AshishCdev/Nelson-pass-Class-A-amplifier/Docs/art_amp_camp_1.pdf

## AMP CAMP AMP #1

by Nelson Pass

Introduction

Do-It-Yourself audio is a great activity. Many major audio components are easily constructed and made to perform as well or better than what we see in the stores and at considerable savings. The process is educational and therapeutic and there are few greater satisfactions than listening to music on equipment you have built yourself.

One of the problems that people face getting involved in DIY audio is the initial hurdle of just getting started. Toward this end, it is a big help if the project is simple and structured and there is some “hand holding” available.

A good example of this is when several years ago Nelson Brock and his family sponsored “Speaker Camp”, an activity in which a number of people paid a modest sum to show up on a Saturday morning and spend the day building their own loudspeakers. At the end of the day they each carted away a respectable stereo pair.

This year in loose association with Burning Amp and DIYAudio, they are holding “Amp Camp”, with the aim of introducing a group of people to DIY amplifier construction. When approached, I offered some design work and parts to assist this effort.

On June 30, about 25 people will show up on the Brock's property, and with a little luck at the end of the day they will cart away 50 small mono-block Class A power amplifiers.

Requirements and Constraints

Building amplifiers is generally a more intimidating challenge than loudspeakers. There are more parts involved, the function of these parts seems more exotic, and they are connected in more complex ways.

In thinking about the design, I considered whether a “chip amp” might be suitable. This would be an amplifier based around a commercially available integrated circuit in which most of the complexity is hidden inside a single component. This approach looks easier, but is a little less “fundamental” than a design using discrete transistors to form the circuit. If you think of this project positioned on a range of DIY complexity, at one extreme you take a pail of sand and start fabricating your own transistors from scratch. At the other end of the scale you go to the store and buy a Bose system. This project leans toward the former.

Besides, who says that discrete designs have to be complicated? It is possible to build a nice amplifier with only a few more connections than a chip amp, and for a little more effort you can learn even more and get more enjoyment out of the finished product.

So Amp Camp Amp #1 is a discrete design using four transistors. It can be built for about the same cost as a chip amp and in the same amount of time. It will not measure as well as chip

amps in some regards, but as a single-ended Class A design with minimal feedback it will sound good and get some high end audiophile respect.

We have to seriously consider safety as a constraint with regard to the power supply circuitry for the amplifier. We assume that most of the participants in this project do not have the skills to safely connect the components which make up an amplifier power supply to the AC power line.

I addressed this by choosing a commercially available switching supply of the type you routinely see powering up your portable computer. There are literally tons of surplus supplies available for this purpose, providing regulated 19 volts DC at more than 2 amps or so on their output and having their input going safely to the wall AC power outlet through a safety approved power cord. These supplies are isolated for shock safety and are also short-protected. At 19 volts output they do not represent much of a hazard to humans.

What? An audiophile component with a switching power supply? Get over it – it works fine.

The Design

As mentioned before, we want a simple, good sounding design. For the past twenty years or so I've been writing up single stage “Zen” amplifiers and other simple designs, and we are going to channel some of those to get what we want. Here is the very simplified circuit:

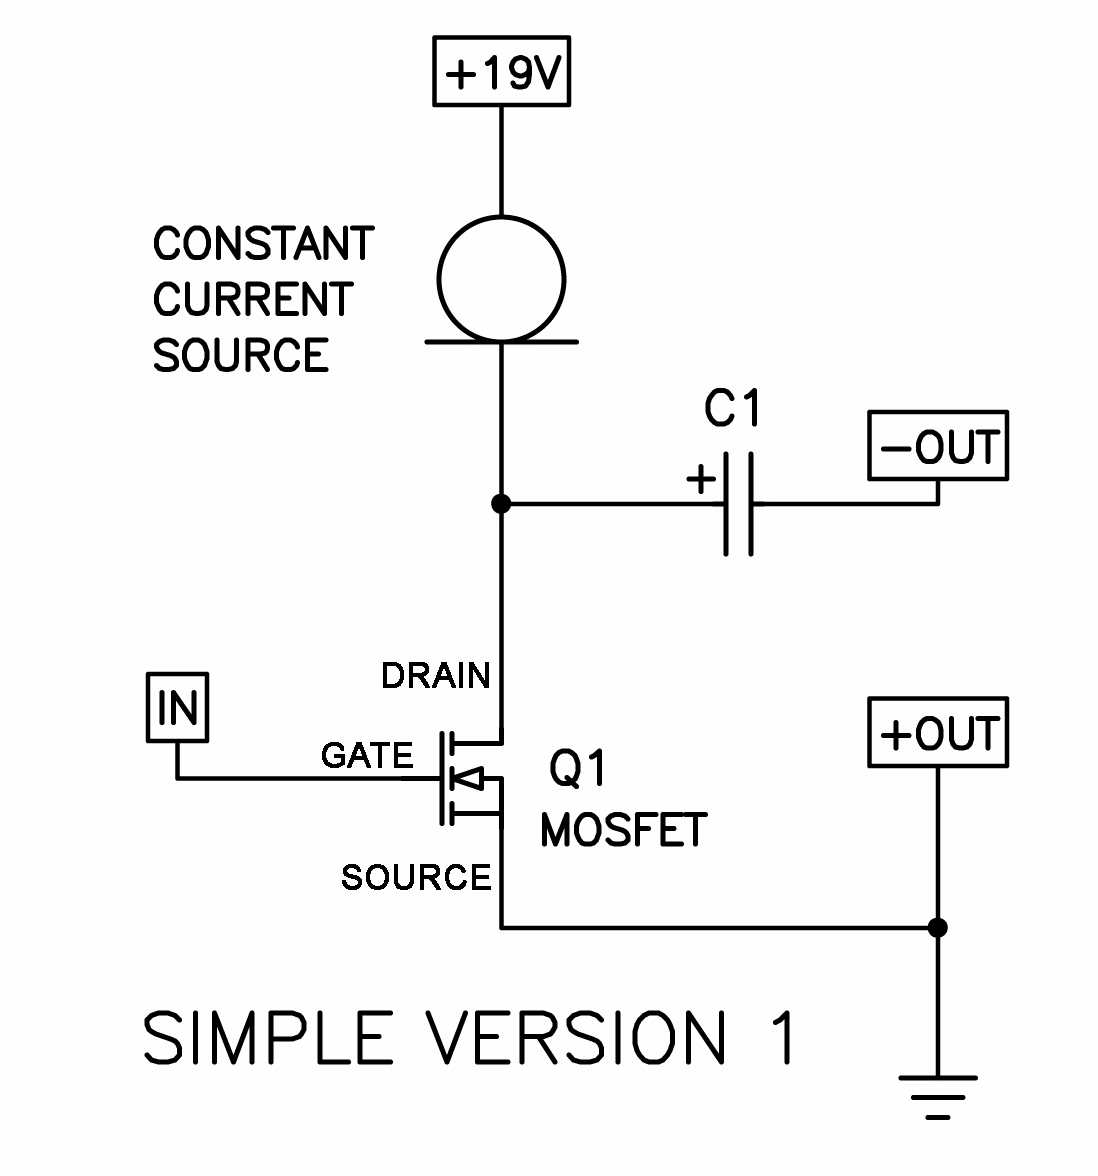
[picture p1: figure]

In this circuit we see a single gain element Q1, an N-channel power Mosfet. In the diagram you will see that the three pins on this device are labeled Source, Drain and Gate. The input signal comes to the Mosfet Gate pin, and the output signals appears at the Drain pin. The Source is attached to circuit Ground. This arrangement is known as “Common-Source” operation. Of the three possible ways of operating a Fet gain device, it is the one that offers both voltage and current gain.

The other two operating modes are known as Common-Drain and Common-Gate. Common-Drain has the signal input going to the Gate pin and takes the output from the Source pin. It offers current gain, but not voltage gain. Common-Gate operation has input to the Source pin and takes the output from the Drain. It offers voltage gain but not current gain.

This Common-Source Mosfet is operated single-ended Class A. This means that power goes into the circuit from one end only, and the transistor will be conducting current at all times through its operation. This current is delivered to the transistor through the Constant Current Source, which is a circuit which provided constant current, (ideally) no matter what the voltage conditions are. This constant current is shared by the Mosfet and the loudspeaker, and the input signal varies the degree to which these elements share this current, and this is what drives the loudspeaker.

We will note that Common-Source operation intrinsically inverts the phase of the amplified signal, and so we have reversed the polarity of the output terminals to account for that.

As a concept, you can buy an integrated circuit constant current source, but we are going to design our own, partly to do-it-ourselves and partly because we want to alter its character a little to improve the performance of the circuit. Here is the circuit with some details added showing the actual discrete circuit of our current source:

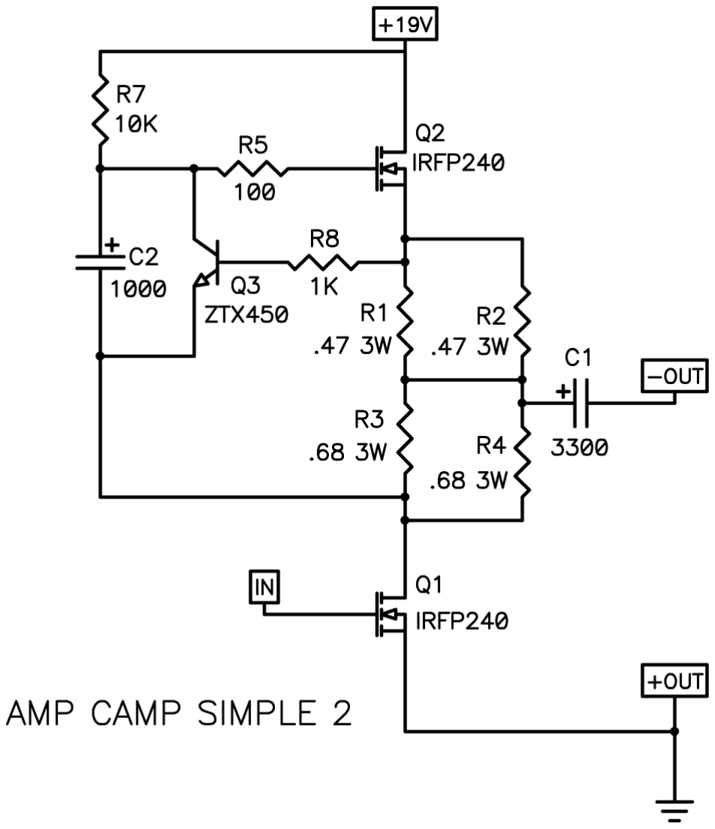
[picture p2: figure]

First we note that Q1 now actually has a part description IRFP240 which is a nice venerable power Mosfet which has been around for over 20 years. There is also Q2 which is the same type of Mosfet. Surrounding Q2 are several resistors, a small transistor Q3, and a capacitor. These elements are chosen to control Q2 in such a way that it acts as a DC constant current source which also varies AC-wise so as to favorably help the amplification provided by Q1.

Q3 is used to set up the DC operation of Q2 by adjusting a constant DC voltage across C2. This sets the current source at a constant DC value by sensing the voltage drop from the Source of Q2 to the Drain of Q1 and keeping the it at the same value as the Base-Emitter voltage required to make Q3 conduct - about 0.65 Volts.

The AC current of this circuit is made variable by tapping the output to the speaker from the midpoint of the power resistors R1 through R4. This sort of arrangement has several names, including SRPP and SEPP, but my favorite is “mu follower”.

The above circuit does not yet make allowance for providing the correct DC voltage on the Gate pin of Q1 so as to conduct electricity. Also, there is not yet a provision for any negative feedback so as to create a low enough output impedance and low enough distortion to make the performance of the amplifier generally attractive.

The circuit below shows additions Q4, P1, C3, and R10 to accomplish these things. C3 allows us to set a DC voltage on the Gate of Q1 (about 4 volts) and we get this through P1 and R10. Q4, a Jfet transistor operated in Common-Drain mode provides a buffer that keeps the input impedance high. This will be helpful in driving the Q1 Gate capacitance when it comes time to enclose this circuit in a feedback loop while keeping the input impedance high enough that it doesn't have problems with the preamp circuits which might be driving this amplifier.

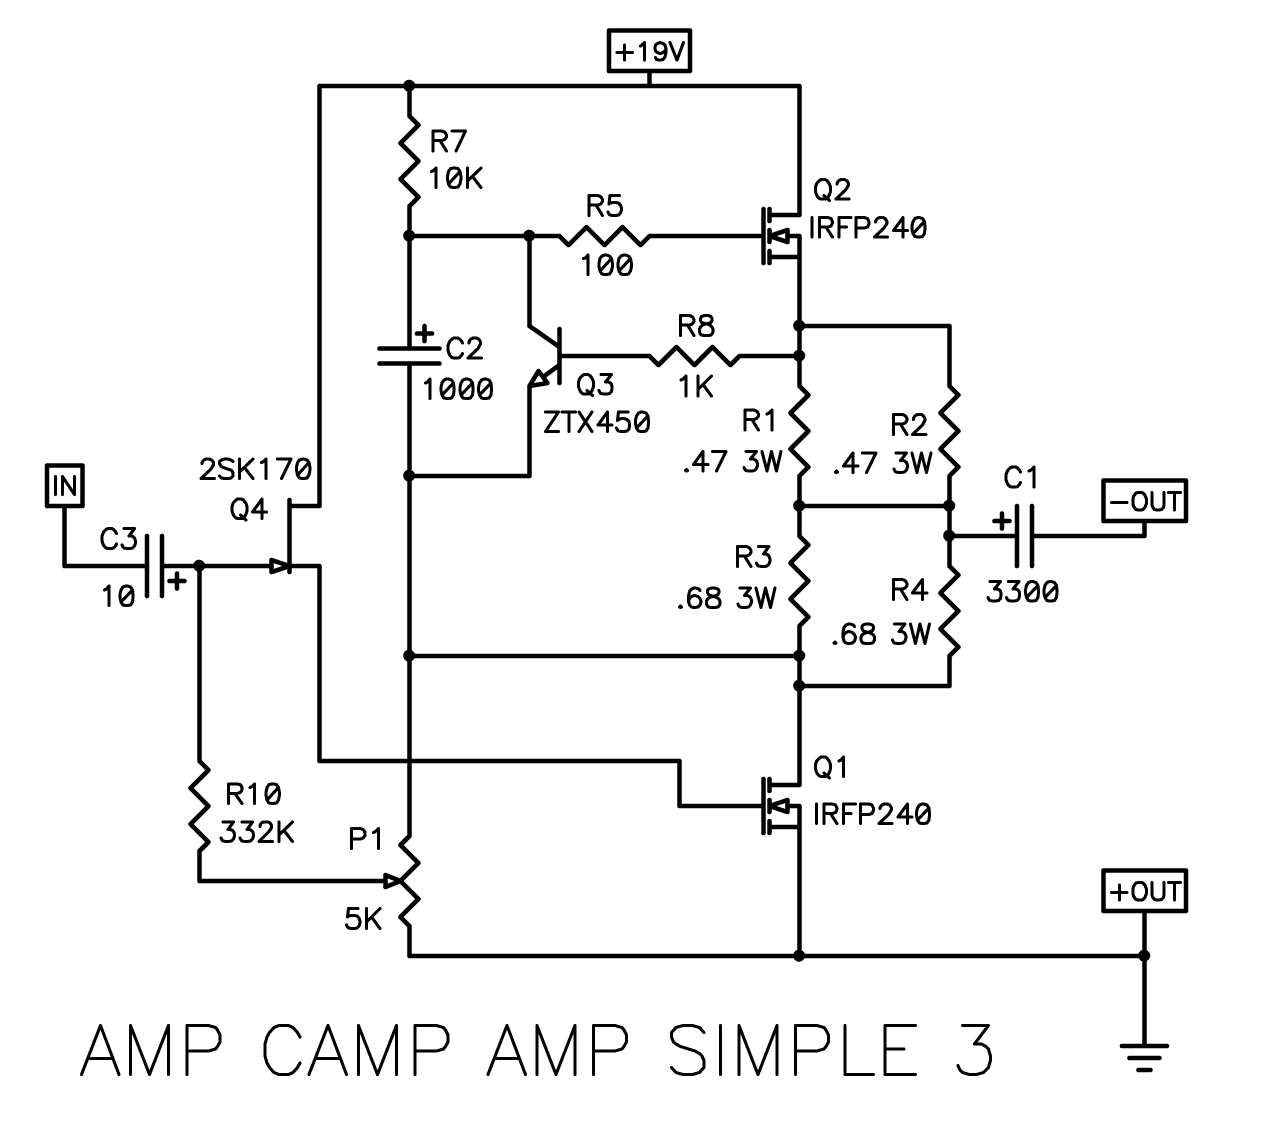
[picture p3: figure]

There are a few more details to be added before we have the final circuit:

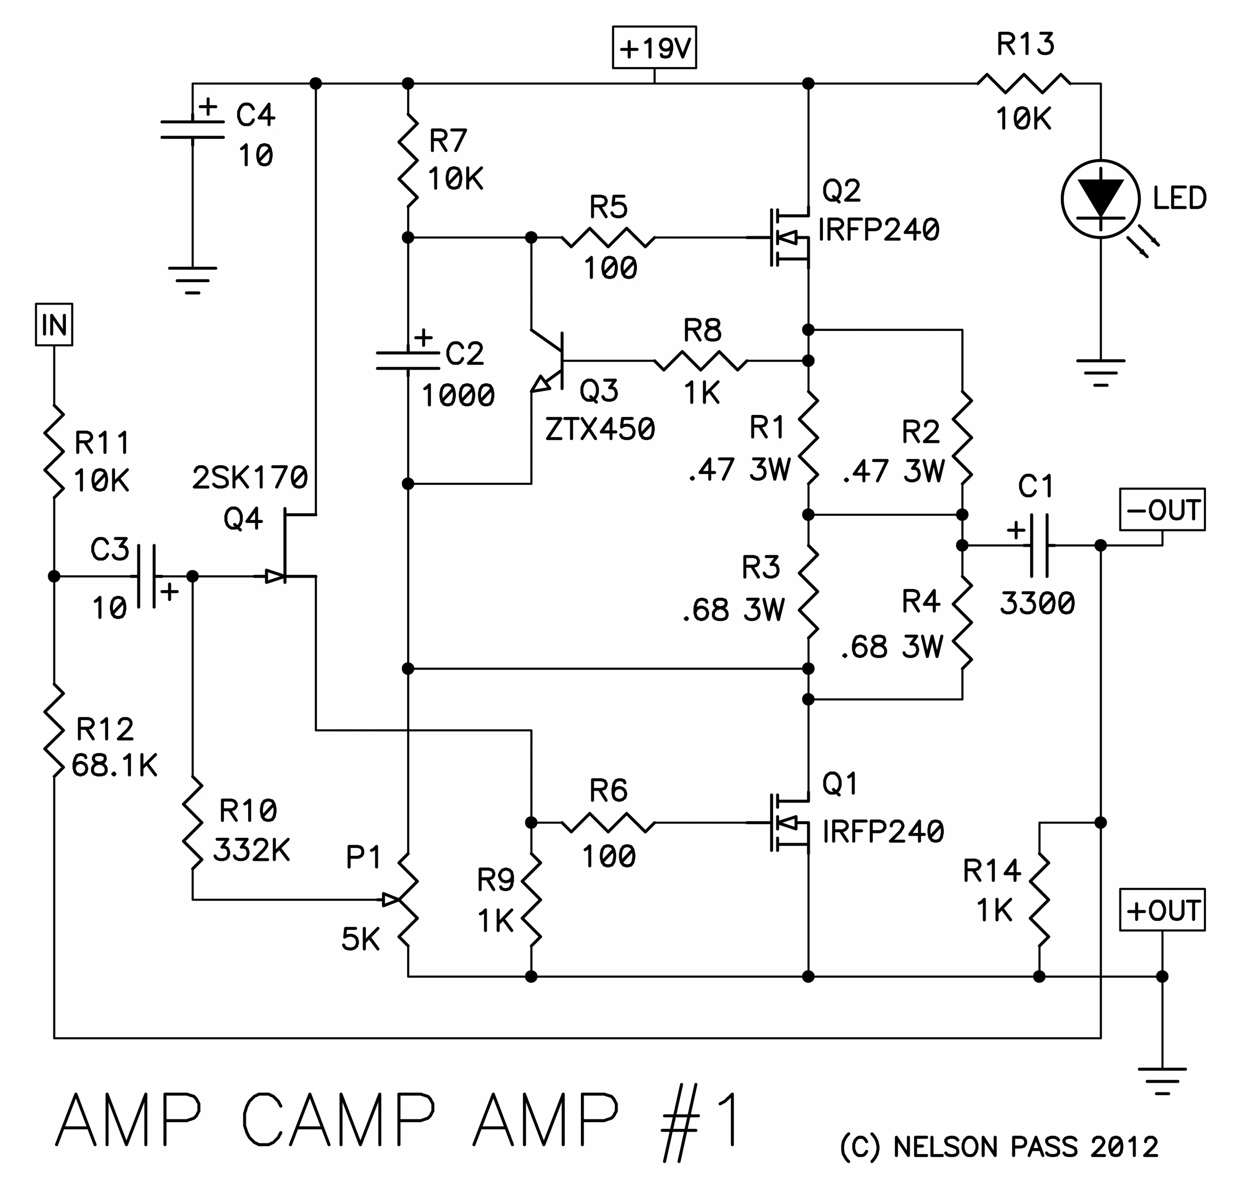
[picture p4: figure]

Here you see the addition of the feedback loop formed by R12 and R11. Also we have added R9 which sets the current value of Q4 and R6 which prevents parasitic oscillation in the Mosfet Q1. Mosfet Q2 has a similar “Gate-stopper” resistor with R5. R14 is used to bleed off DC voltage through C1, preventing thumps from the addition or removal of sources and loads.

And of course we need an LED of some sort and a resistor for it, which would be R13.

Performance

Constructing this circuit results in a power amplifier which has 14 dB of voltage gain and 5 watts of output. The input impedance is 10 Kohm, and the damping factor is about 3. The output noise with the switching supply comes in around 100 uV.

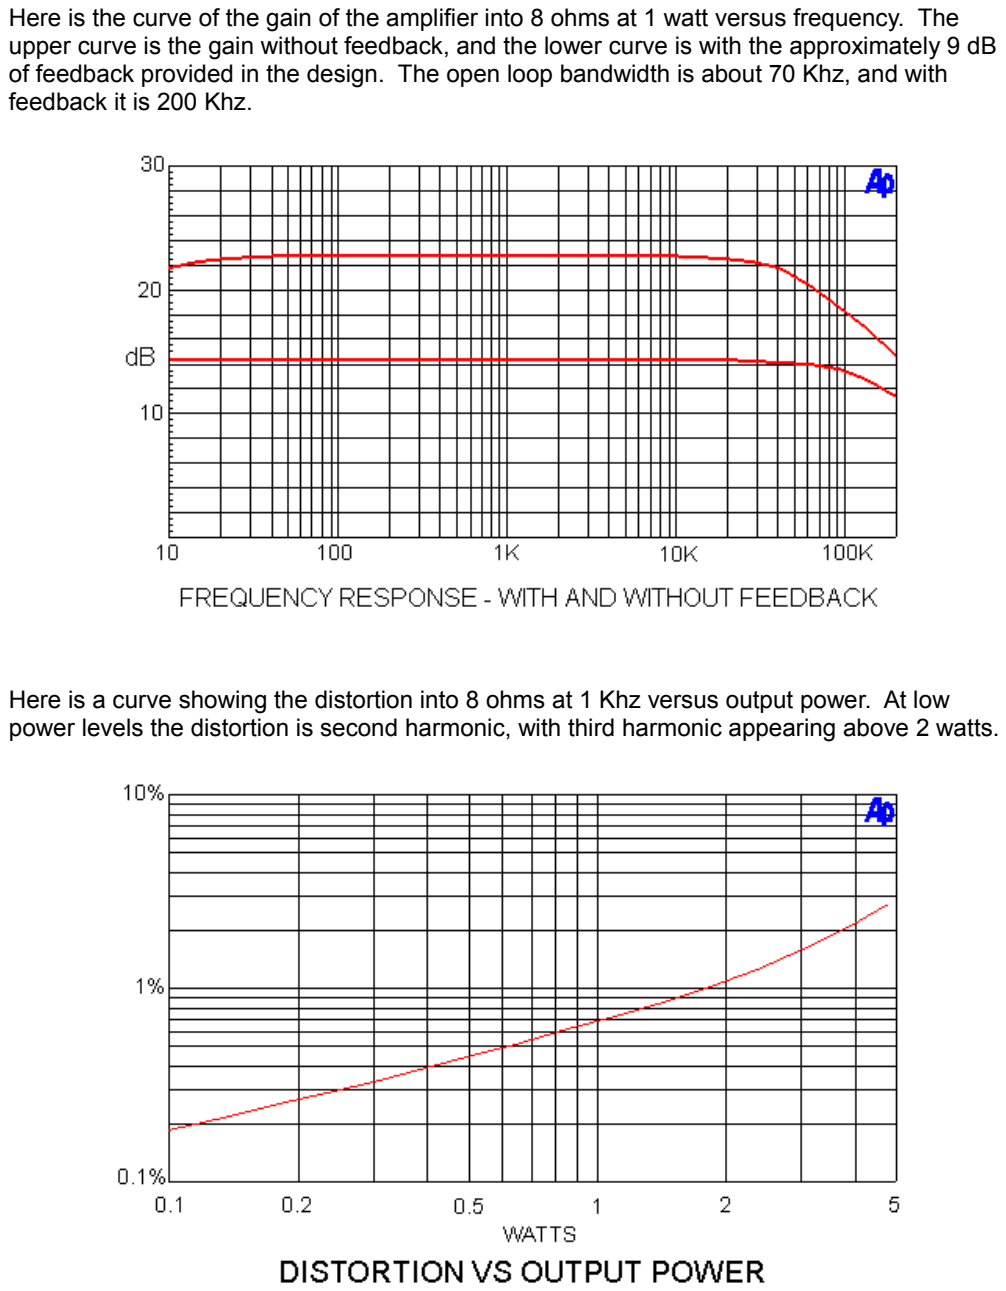
[picture p5: page 6]

Here is the curve of the gain of the amplifier into 8 ohms at 1 watt versus frequency. The upper curve is the gain without feedback, and the lower curve is with the approximately 9 dB of feedback provided in the design. The open loop bandwidth is about 70 Khz, and with feedback it is 200 Khz.

Here is a curve showing the distortion into 8 ohms at 1 Khz versus output power. At low power levels the distortion is second harmonic, with third harmonic appearing above 2 watts.

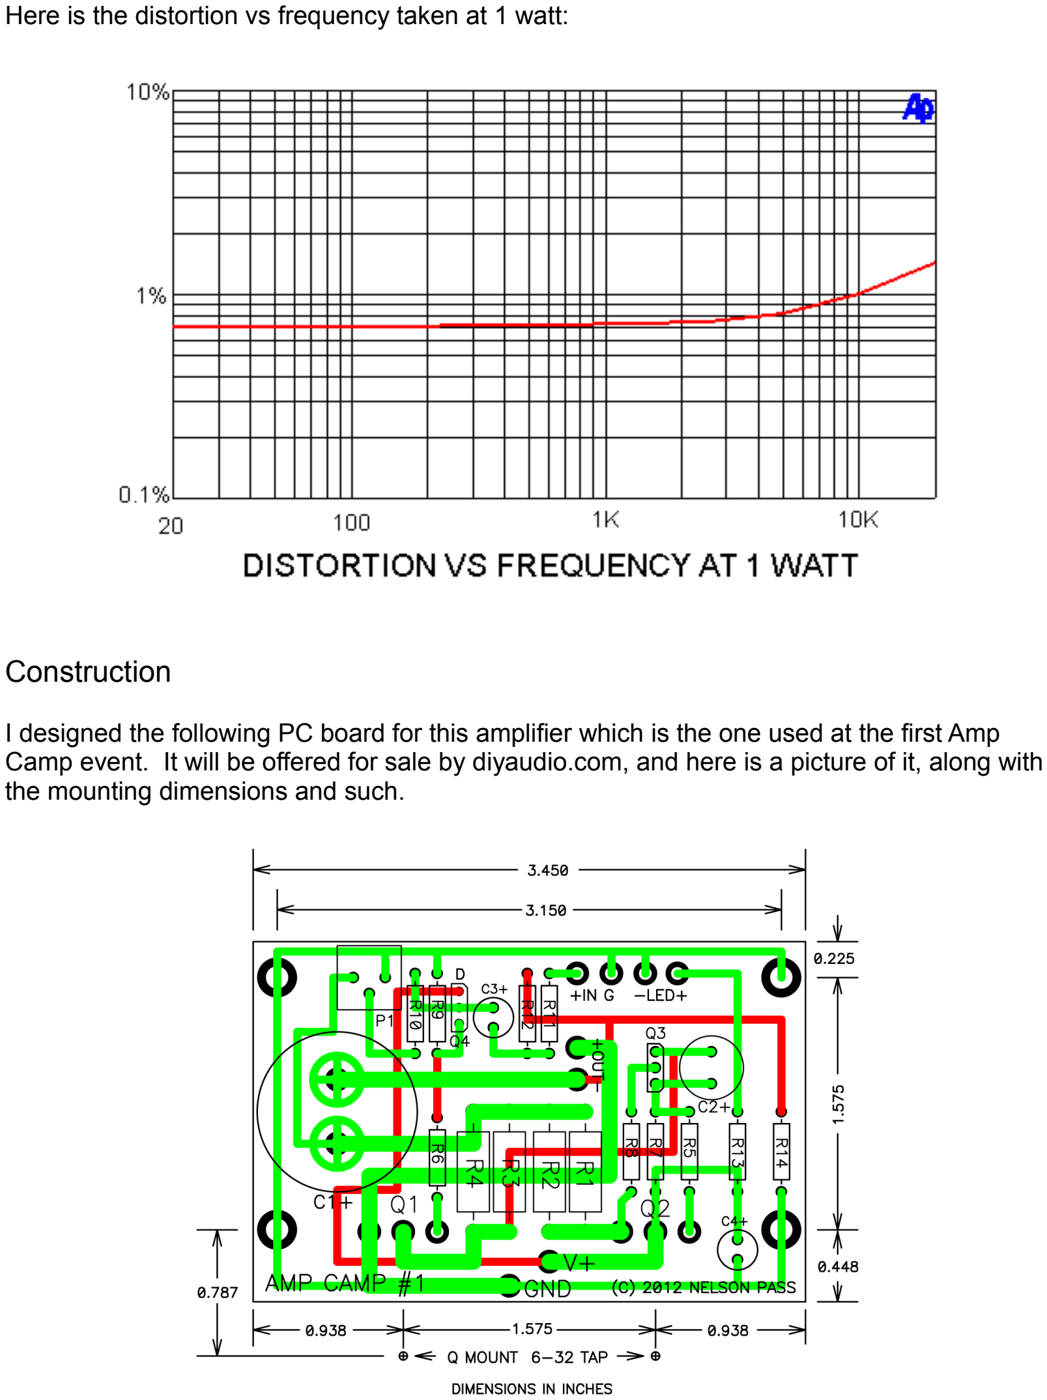
[picture p6: page 7]

Here is the distortion vs frequency taken at 1 watt:

Construction

I designed the following PC board for this amplifier which is the one used at the first Amp Camp event. It will be offered for sale by diyaudio.com, and here is a picture of it, along with the mounting dimensions and such.

It is designed to mount on the flat surface of a heat sink with the output devices. Each channel of the amplifier has its own switching power supply and draws about 1 amp of current DC. The supply should be capable of delivering more than 2 amps of current short term. At 19 volts, the dissipation of the amplifier is about 20 watts, and the heat sink it is mounted on should not be allowed to get more than about 25 degrees Centigrade above the ambient temperature. This means that the rating of the sink should be around 1 deg C per watt.

The power transistors must be well attached to the heat sink since they dissipate about 10 watts each. As the cases of the transistors are electrically live, they must be insulated from the heat sink by electrically non-conductive but thermally conductive material, either commercial silicone TO-3P insulators or equivalent mica pads and thermal grease.

Here is a clear picture of the component placement:

Parts

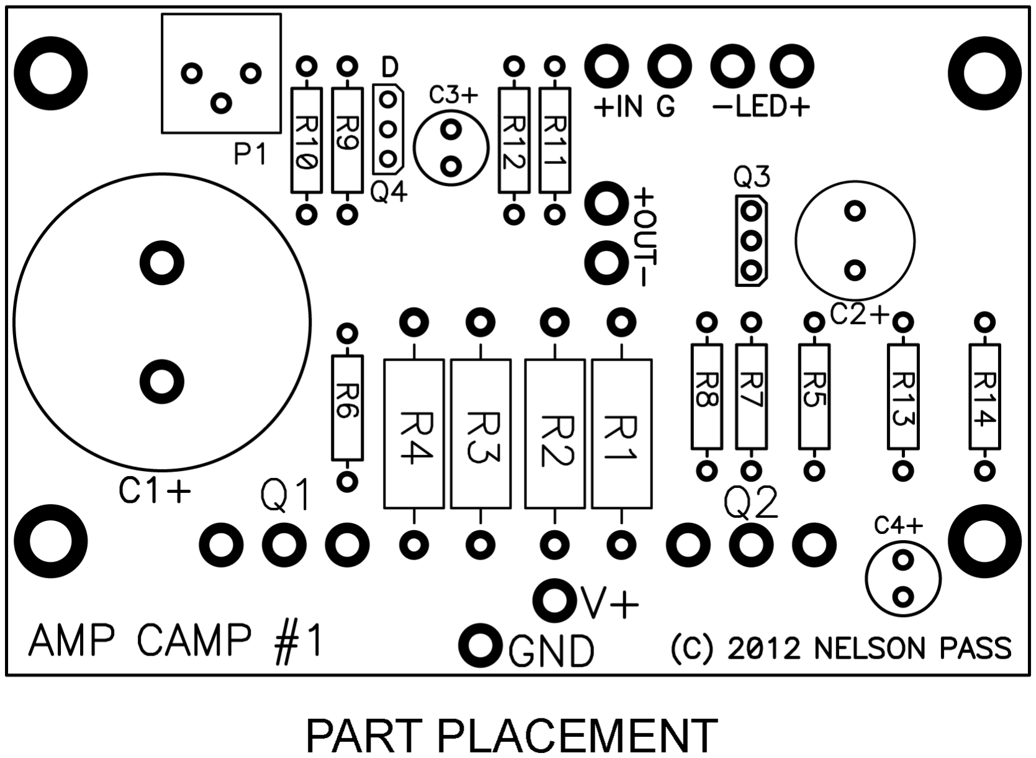
[picture p7: figure]

A couple of notes about parts: Feel free to try different parts and different values, as there is nothing that critical about much of this design. Remember that Mosfets are static sensitive, so use a little common sense in handling them.

I chose the 10 uF caps as the Elna Silmics because they are cheap and very good. The 3300 uF cap will never see even 20 volts, but greater than 25 volts leaves margin for lower distortion.

If you can't find the Toshiba Jfets, you will find that the Linear Systems LSK170 is much more than adequate as a replacement, and is not expensive.

You can substitute other Mosfets into this design, but keep in mind that they all must be Enhancement mode parts requiring a Gate to Source bias of a least a volt (these are 4 volts) or it will not work. Depletion mode parts won't work at all.

Part List

Here are the parts references, most with Digikey ordering numbers and the current unit price.

Q1, Q2 | IRFP240 | Digikey # IRFP240PBF-ND | $2.19
Q3 | ZTX450 | Digikey # ZTX450-ND | $0.67
Q4 | 2SK170, LSK170 www.linearsystems.com | ~$1.00
R1, R2 | 0.47 ohms 3 watt Digikey # P0.47W-3BK-ND | $0.53
R3, R4 | 0.68 ohms 3 watt Digikey # P0.68W-3BK-ND | $0.53
R5, R6 | 100 ohms 0.4W | Digikey # PPC100YCT-ND | $0.18
R7, R11, R13 | 10K ohms 0.4W | Digikey # PPC10.0KYCT-ND | $0.18
R8, R9, R14 | 1K ohms 0.4W | Digikey # PPC1.00KYCT-ND | $0.18
R10 | 332K ohms 0.4W Digikey # PPC332KYCT-ND | $0.18
R12 | 68.1K ohms 0.4W Digikey # PPC68.1KYCT-ND | $0.18
C1 | 3300 uF 35V | Digikey # P6596-ND | $1.99
C2 | 1000 uF 16V | Digikey # P13119-ND | $0.67
C3, C4 | 10 uF 25V | Digikey # 604-1050-ND | $0.30
P1 | 5K Pot | Digikey # 3386P-502LF-ND | $1.33

Let's see... That comes to about $14.25 not counting shipping or tax. Also not counting hardware, pc board, connectors, and heat sinks. I got the power supplies from Marlin P Jones for about $5. With the power cord!

Adjustments

There is only one adjustment, assuming that you have built the circuit as described, and that is to adjust P1 so that the Drain pin of Q1 is set at 10 volts DC. After you have set P1, you need to let the amplifier spend some time warming up, say a half hour, and then adjust it to 10 volts again. Then do this one last time after another half hour.

While the amplifier is warming up, the cover should be set in place so as to simulate the ventilation that the channel will experience under the same thermal conditions as normal operation.

That all there is to it.

Here's a couple of photos that Nelson Brock took of the not-quite-finished prototypes:

Conclusion

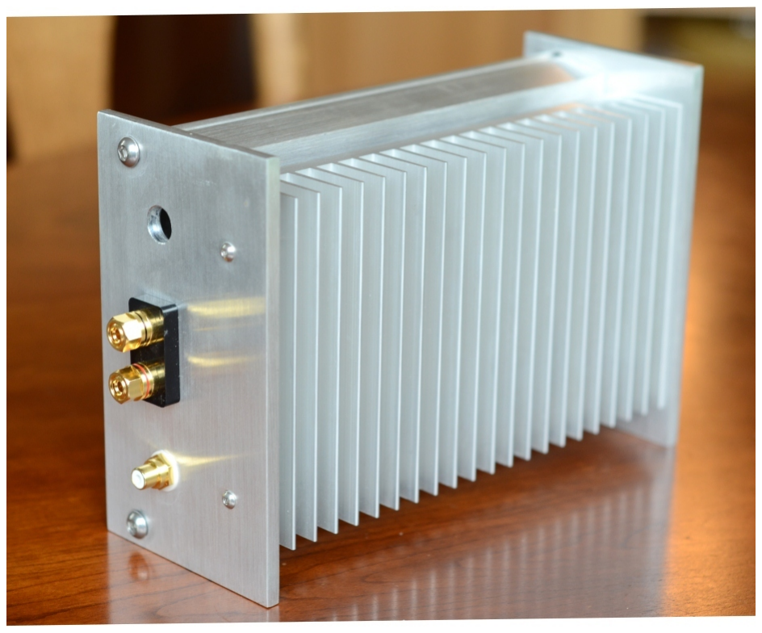
[picture p8: figure]
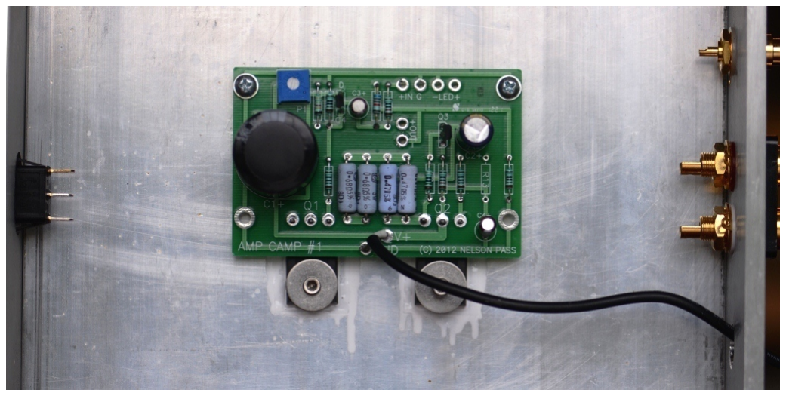
[picture p9: figure]

And there we have it. I write this in anticipation of the first Amp Camp event, and I expect a few surprises and a lot of happy faces, my birthday present to myself.

Remember, the whole idea is for you first-timers to get your feet wet in the shallow end of the pool. Put on some sun screen, and come on in.

The water's fine.

© Nelson Pass 2012
