AshishCdev/Nelson-pass-Class-A-amplifier/(list of files, drawings)

Other design files:
layout/1stWatt.lay6
Simulation/SimulationNelsonPassClassA.pdsprj
