AshishCdev/Nelson-pass-Class-A-amplifier/Kicad_old/AMP CAMP AMP 1.6.kicad_pcb

## KiCad design Kicad_old/AMP CAMP AMP 1.6.kicad_pcb (2020-09-19, an earlier design)

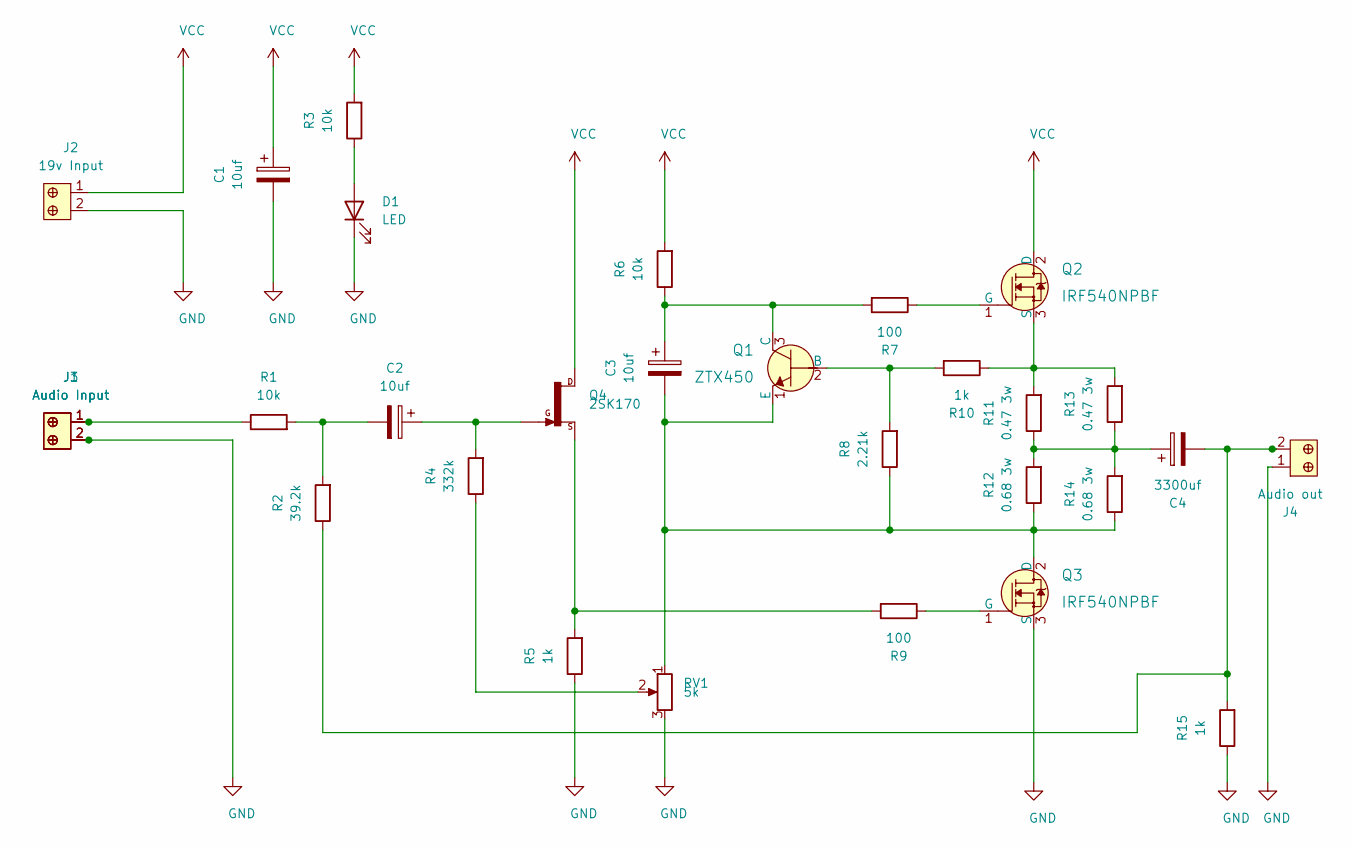
[picture p10: schematic AMP CAMP AMP 1.6.kicad_sch, Nelson Pass Camp Amp]

Parts:
C1, C2, C3: 10uf; R_0402_1005Metric
C4: 3300uf; R_0402_1005Metric
D1: LED; LED_1210_3225Metric_Pad1.42x2.65mm_HandSolder
J1, J3: Audio Input; Term_Block_1x2_P5.08MM; MPN OSTTC022162; Digi-Key_PN ED2609-ND
J2: 19v Input; Term_Block_1x2_P5.08MM; MPN OSTTC022162; Digi-Key_PN ED2609-ND
J4: Audio out; Term_Block_1x2_P5.08MM; MPN OSTTC022162; Digi-Key_PN ED2609-ND
Q1: ZTX450; TO-92-3; MPN ZTX450; Digi-Key_PN ZTX450-ND
Q2, Q3: IRF540NPBF; TO-220-3; MPN IRF540NPBF; Digi-Key_PN IRF540NPBF-ND
Q4: 2SK170; TO-92-3
R1, R3, R6: 10k; R_0402_1005Metric
R2: 39.2k; R_0402_1005Metric
R4: 332k; R_0402_1005Metric
R5, R10, R15: 1k; R_0402_1005Metric
R7, R9: 100; R_0402_1005Metric
R8: 2.21k; R_0402_1005Metric
R11, R13: 0.47 3w; R_0402_1005Metric
R12, R14: 0.68 3w; R_0402_1005Metric
RV1: 5k; Potentiometer_ACP_CA9-H5_Horizontal

Connections:
GND: C1.2, D1.1 (K), J1.2, J2.2, J3.2, J4.1, Q3.3 (S), R5.1, R15.1, RV1.3
unnamed: C2.1, Q4.2, R4.2
unnamed: C2.2, R1.2, R2.2
unnamed: C3.1, Q1.3 (C), R6.1, R7.2
unnamed: C3.2, Q1.1 (E), Q3.2 (D), R8.1, R12.1, R14.1, RV1.1
unnamed: C4.1, R11.1, R12.2, R13.1, R14.2
unnamed: C4.2, J4.2, R2.1, R15.2
unnamed: D1.2 (A), R3.1
unnamed: J1.1, J3.1, R1.1
unnamed: Q1.2 (B), R8.2, R10.2
unnamed: Q2.1 (G), R7.1
unnamed: Q2.3 (S), R10.1, R11.2, R13.2
unnamed: Q3.1 (G), R9.1
unnamed: Q4.3, R5.2, R9.2
unnamed: R4.1, RV1.2
VCC: C1.1, J2.1, Q2.2 (D), Q4.1, R3.2, R6.2

Board: 2 copper layers, 29 parts (0 on the bottom side), 16 nets, no tracks yet.
