AshishCdev/Nelson-pass-Class-A-amplifier/(commit log)

2020-09-19 Schematic done
    [AMP CAMP AMP 1.6.kicad_pcb, AMP CAMP AMP 1.6.kicad_sch]
2021-02-13 Updated the layout from PCB
    [1stWatt.lay6, AMP CAMP AMP 1.6.kicad_pcb, AMP CAMP AMP 1.6.kicad_sch, SimulationNelsonPassClassA.pdsprj]
